slavomirStucka/Automated-feeder/README.md

# Automatic Feeder Project

## Overview
This project is an Arduino-based **Automatic Feeder**, designed and developed by me and my classmates as part of a school project. The system dispenses food at scheduled intervals.

## Components
- Arduino Uno
- Servo motor
- RTC module (Real-Time Clock)
- Hopper/Feeder system
- LCD display

## Usage
1. Build the circuit using the included diagram.
2. Upload the provided code to the Arduino.
3. Set feeding times via the buttons and LCD interface.
